buildbotics/bbctrl-pcb-new/footprints/SOD-523_0P9X1P3_ONS.step

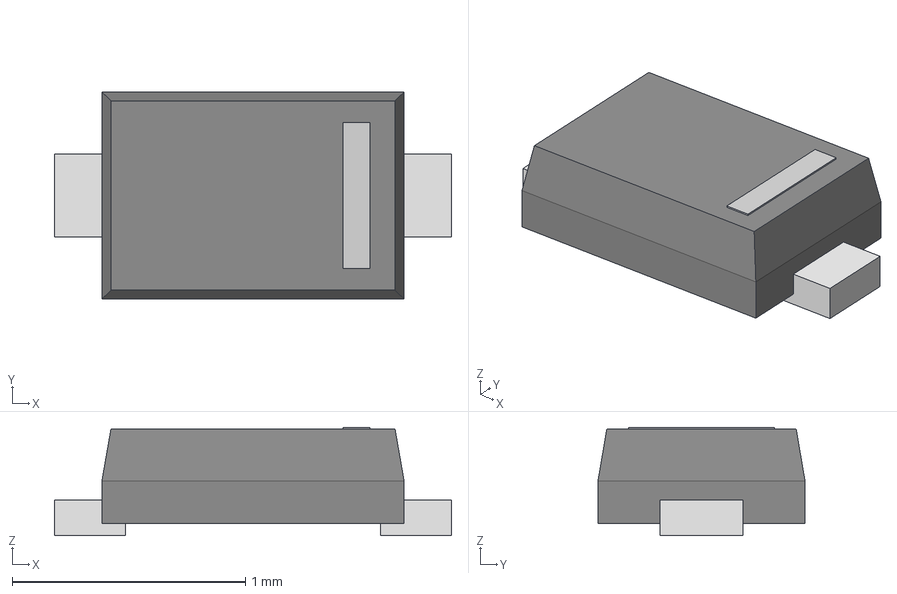
[picture p1: CAD file, 2023-02-12]
footprints/SOD-523_0P9X1P3_ONS.step
1.70 x 0.888 x 0.464 mm
