buildbotics/bbctrl-pcb-new/models/Molex_-_39-30-0060.step

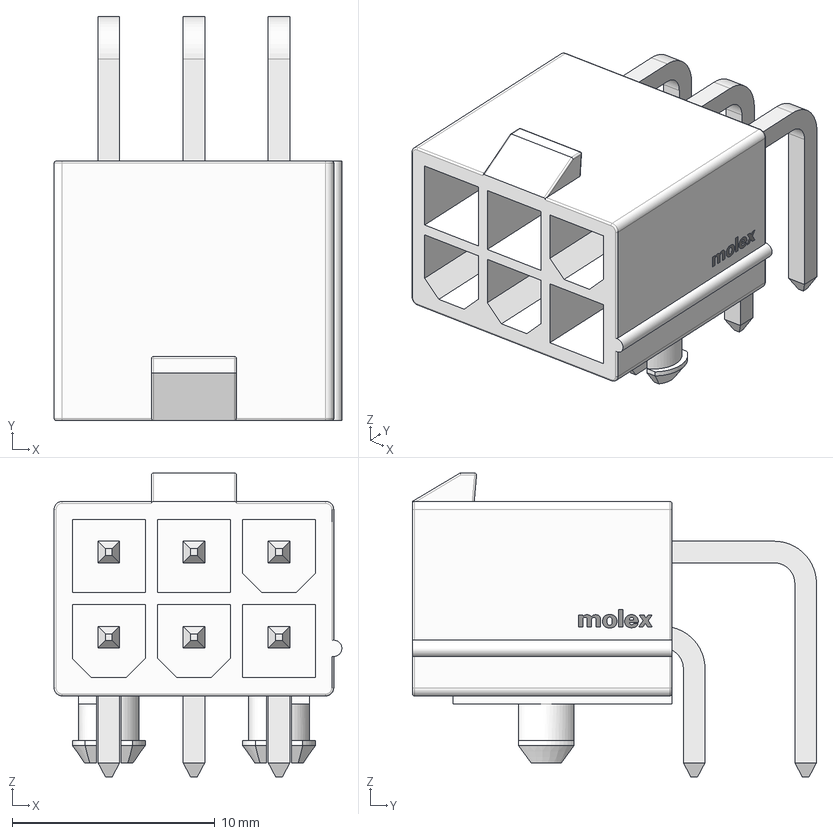
[picture p2: CAD file, 2023-07-27]
models/Molex_-_39-30-0060.step
14.2 x 19.9 x 15.0 mm
39300060_PART1 Matte Tin
Molex
