buildbotics/bbctrl-pcb-new/models/DDW0044B.stp

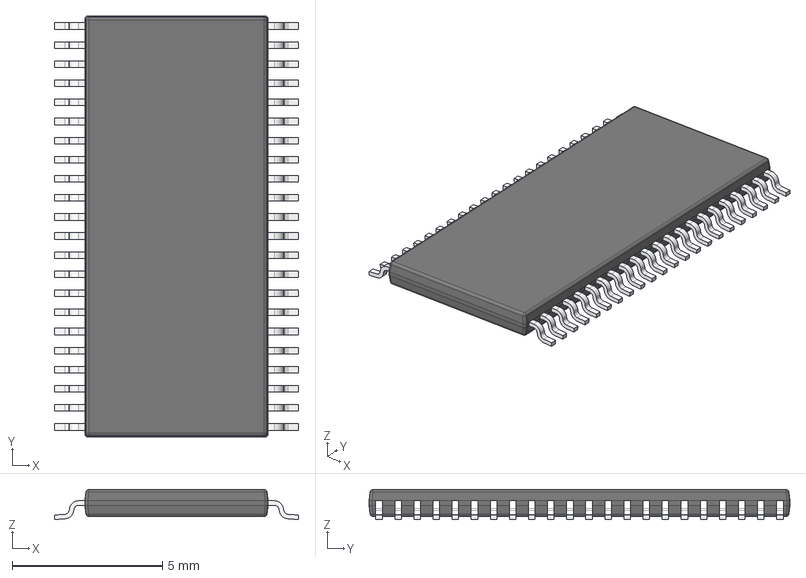
[picture p3: CAD file, 2023-04-26]
models/DDW0044B.stp
8.12 x 14.0 x 1.00 mm
BODY-SO
LEAD-SO x 44
THERMALPAD-SO
PIN1-ID
