buildbotics/bbctrl-pcb-new/models/PW0024A.stp

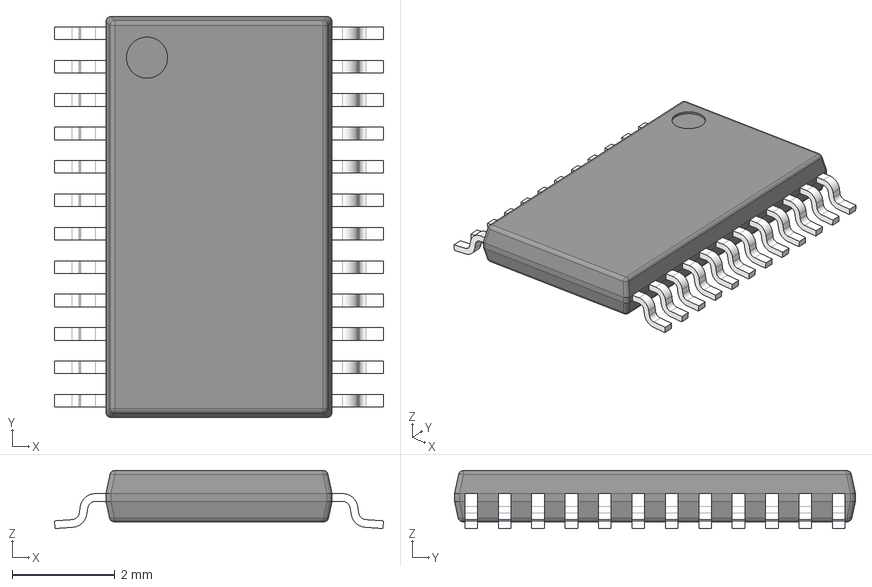
[picture p4: CAD file, 2023-04-26]
models/PW0024A.stp
6.40 x 7.80 x 1.13 mm
BODY-TSSOP
LEAD-TSSOP x 24
PIN1
