buildbotics/bbctrl-pcb-new/models/DIO_RB731_ROM.step

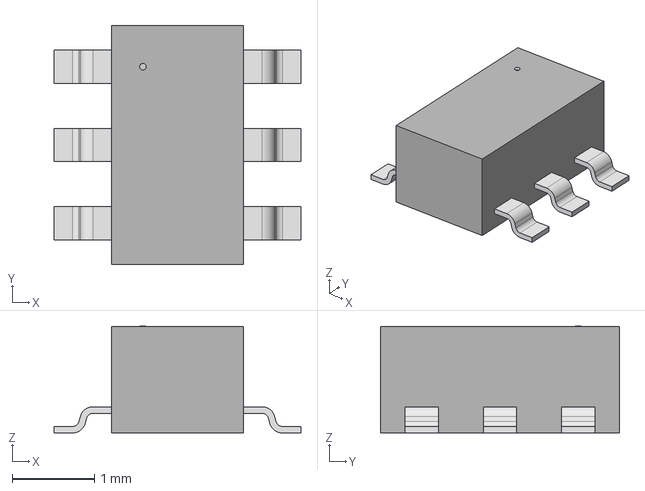
[picture p5: CAD file, 2023-04-26]
models/DIO_RB731_ROM.step
3.00 x 2.90 x 1.30 mm
