buildbotics/bbctrl-pcb-new/models/SOT23_BC856B_NEX.step

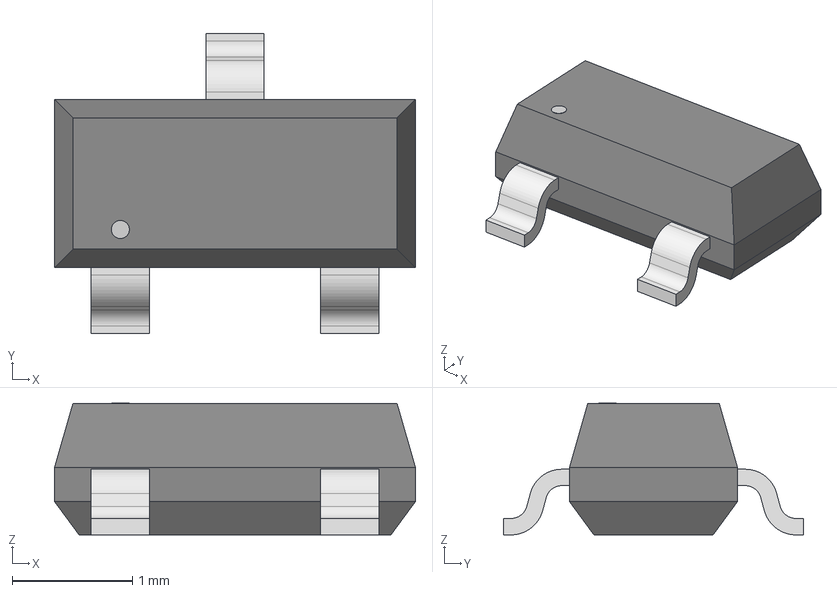
[picture p6: CAD file, 2023-02-12]
models/SOT23_BC856B_NEX.step
3.00 x 2.49 x 1.09 mm
