buildbotics/bbctrl-pcb-new/models/SOT-223_3P7X6P7_ONS.step

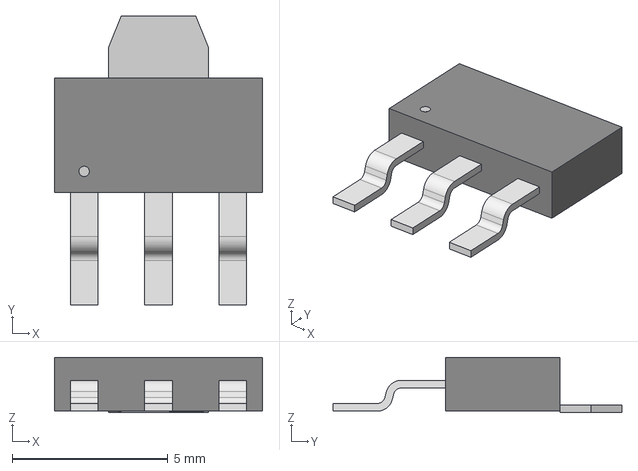
[picture p7: CAD file, 2023-02-12]
models/SOT-223_3P7X6P7_ONS.step
6.68 x 9.27 x 1.78 mm
