buildbotics/bbctrl-pcb-new/models/HTSSOP16_STM.step

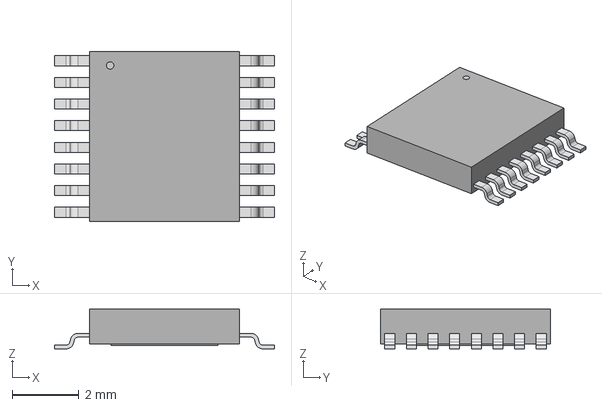
[picture p8: CAD file, 2022-10-26]
models/HTSSOP16_STM.step
6.60 x 5.11 x 1.20 mm
