buildbotics/bbctrl-pcb-new/models/IND_BOURNS_SRF2012A.step

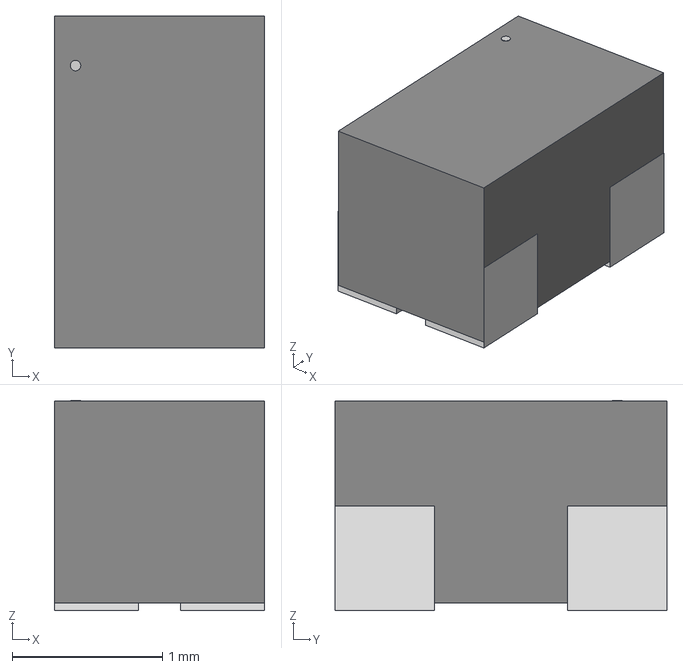
[picture p9: CAD file, 2022-10-26]
models/IND_BOURNS_SRF2012A.step
1.40 x 2.21 x 1.40 mm
