buildbotics/bbctrl-pcb-new/models/SMD_ABLS_11P4X4P7_ABR.step

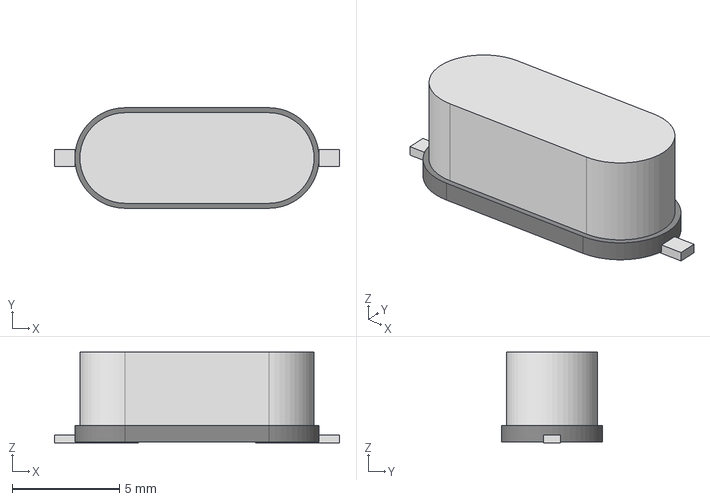
[picture p10: CAD file, 2022-10-26]
models/SMD_ABLS_11P4X4P7_ABR.step
13.3 x 4.70 x 4.24 mm
