buildbotics/bbctrl-pcb-new/models/SOIC_012IDT_STM.step

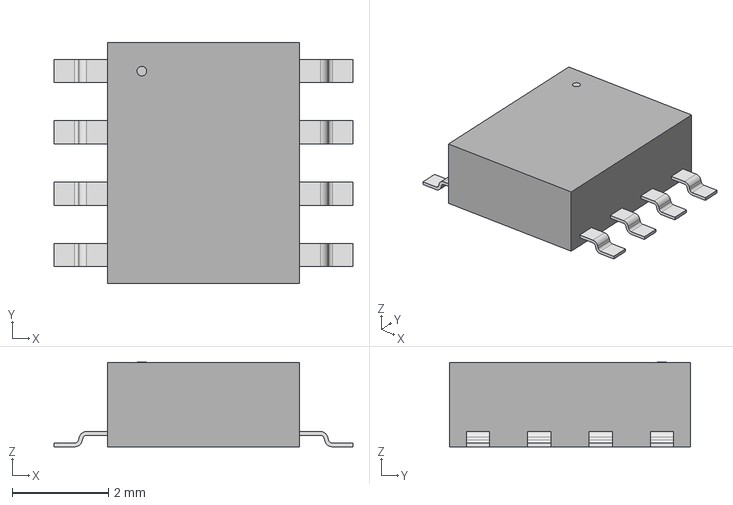
[picture p11: CAD file, 2022-10-26]
models/SOIC_012IDT_STM.step
6.20 x 5.00 x 1.75 mm
