buildbotics/bbctrl-pcb-new/models/CDBW.step

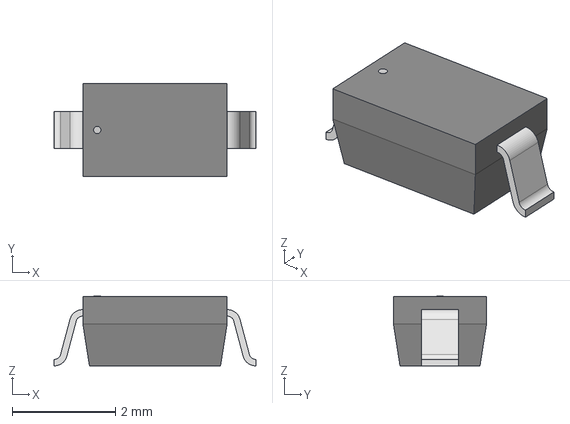
[picture p12: CAD file, 2022-10-26]
models/CDBW.step
3.91 x 1.80 x 1.35 mm
