buildbotics/bbctrl-pcb-new/models/NRS5040T3R3NMGJ.stp

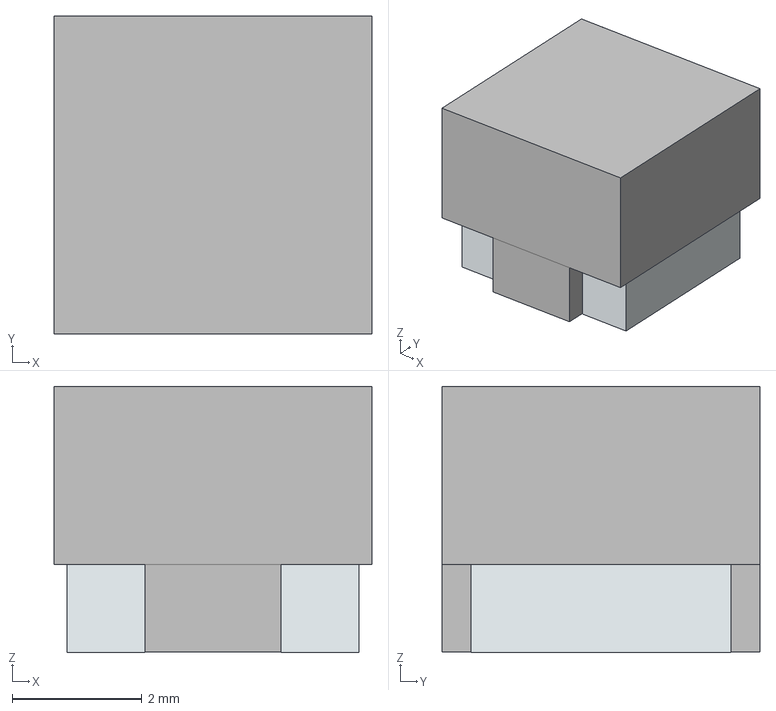
[picture p13: CAD file, 2022-10-26]
models/NRS5040T3R3NMGJ.stp
4.90 x 4.90 x 4.10 mm
solidBody
solidLead
