buildbotics/bbctrl-pcb-new/models/ON_Semiconductor_-_NVMFD5C672NLT1G.step

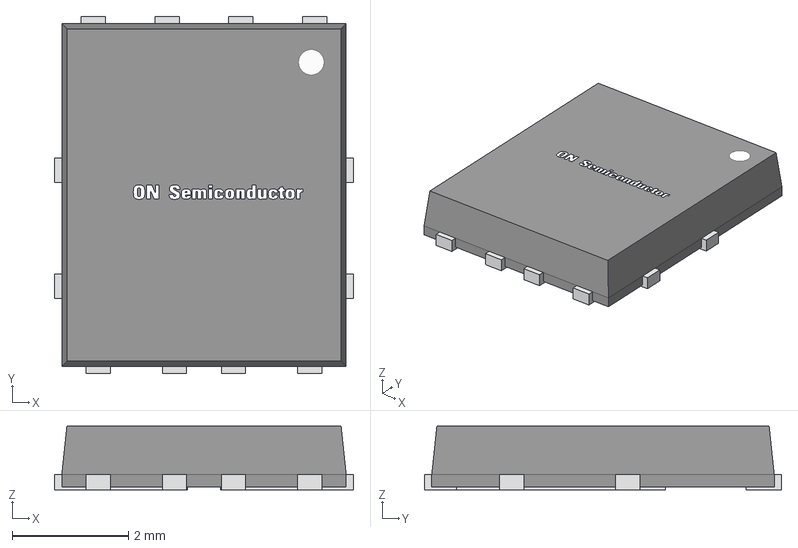
[picture p14: CAD file, 2022-10-26]
models/ON_Semiconductor_-_NVMFD5C672NLT1G.step
5.15 x 6.15 x 1.10 mm
ON Semiconductor NVMFD5C672NLT1G 1
ON Semiconductor NVMFD5C672NLT1G 2
ON Semiconductor
