buildbotics/bbctrl-pcb-new/models/TQFP-EP48_TRI.step

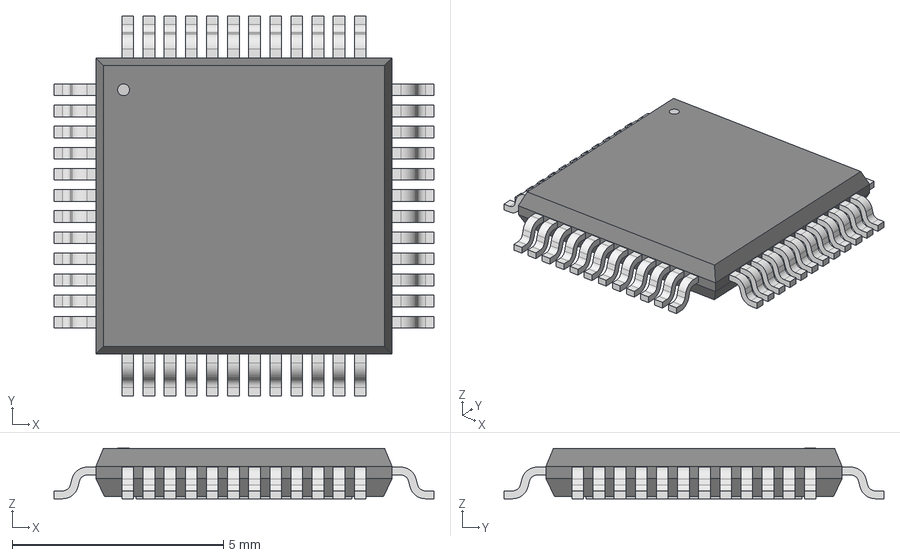
[picture p15: CAD file, 2022-10-26]
models/TQFP-EP48_TRI.step
8.99 x 8.99 x 1.20 mm
