buildbotics/bbctrl-pcb-new/models/DGQ0010D.stp

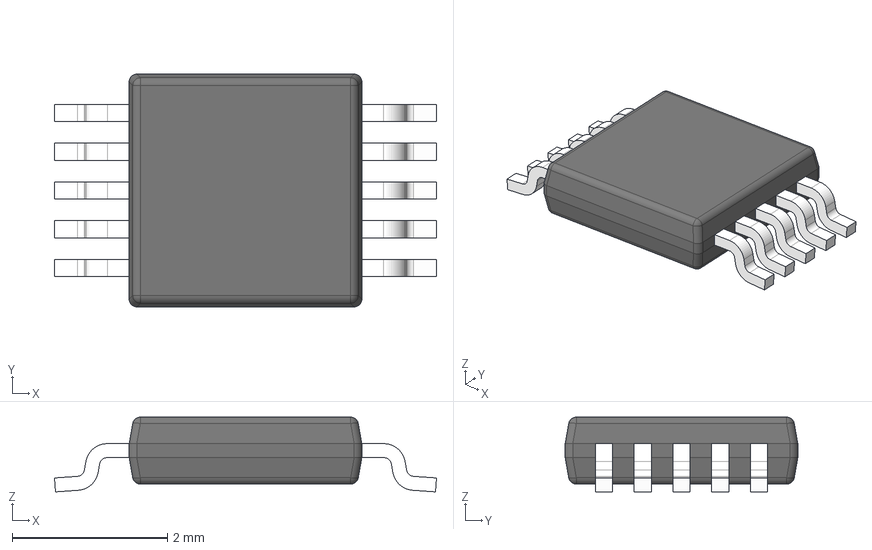
[picture p16: CAD file, 2022-10-26]
models/DGQ0010D.stp
4.93 x 3.00 x 0.964 mm
BODY-SO
LEAD-SO x 10
THERMALPAD-SO
