buildbotics/bbctrl-pcb-new/models/On_Semiconductor_-_NTD5867NLT4G.step

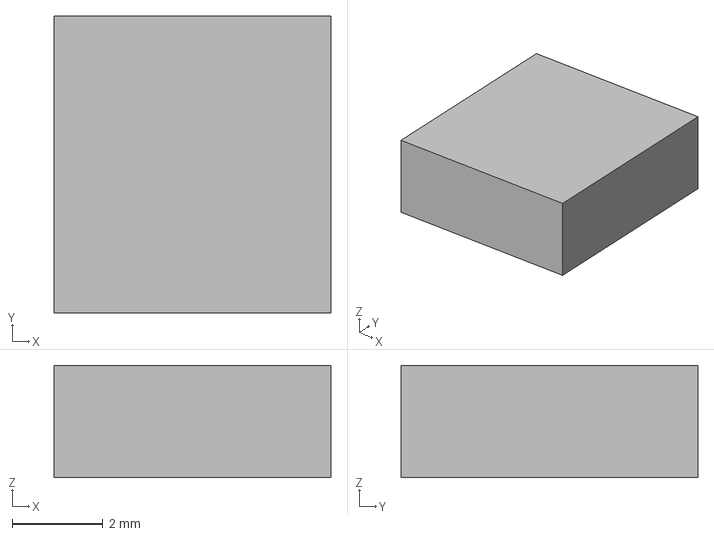
[picture p17: CAD file, 2022-10-26]
models/On_Semiconductor_-_NTD5867NLT4G.step
6.10 x 6.54 x 2.47 mm
