buildbotics/bbctrl-pcb-new/models/SOIC8_4X5_REN.step

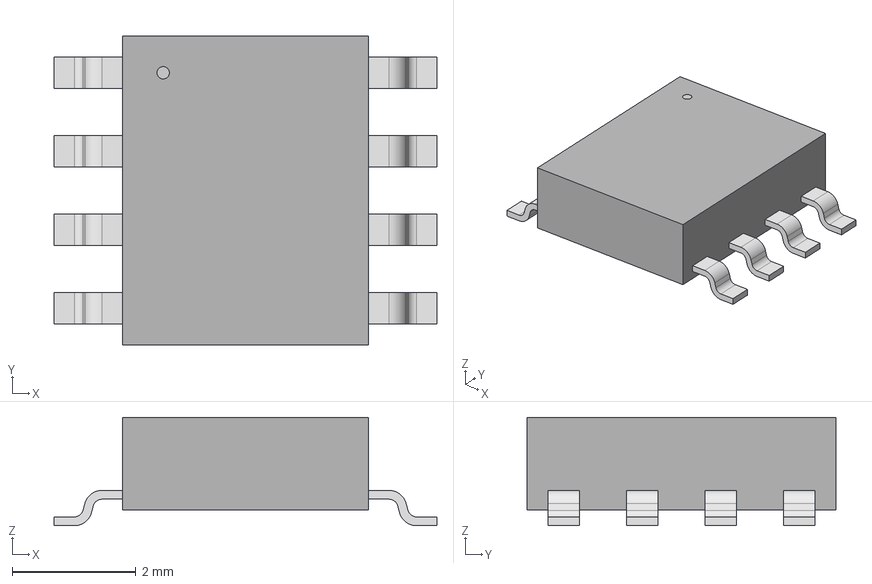
[picture p18: CAD file, 2022-10-26]
models/SOIC8_4X5_REN.step
6.20 x 5.00 x 1.75 mm
