buildbotics/bbctrl-pcb-new/models/DLW21HN121SQ2L.stp

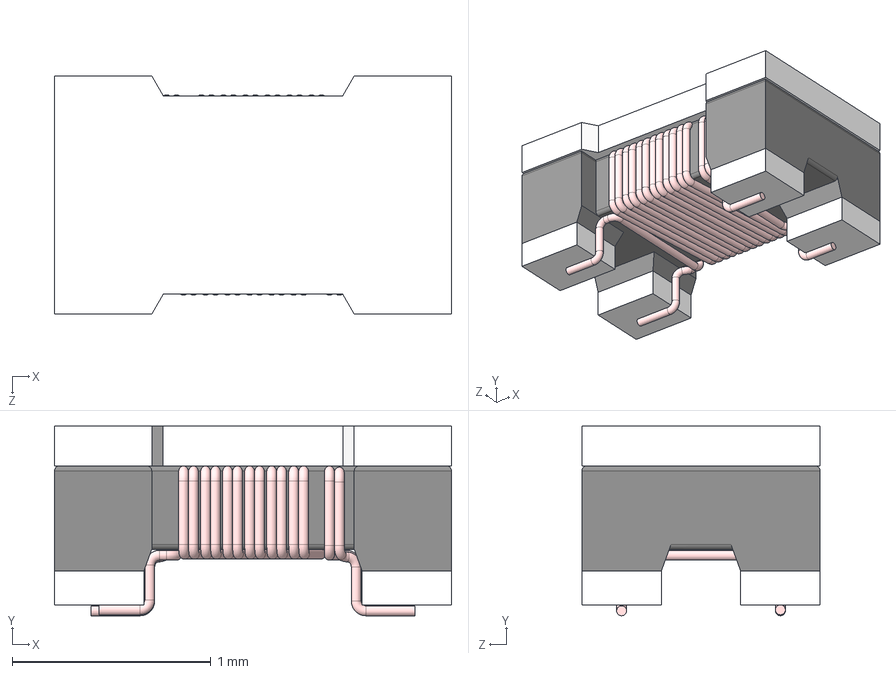
[picture p19: CAD file, 2022-10-26]
models/DLW21HN121SQ2L.stp
2.00 x 0.955 x 1.20 mm
