buildbotics/bbctrl-pcb-new/models/DCP0038A.stp

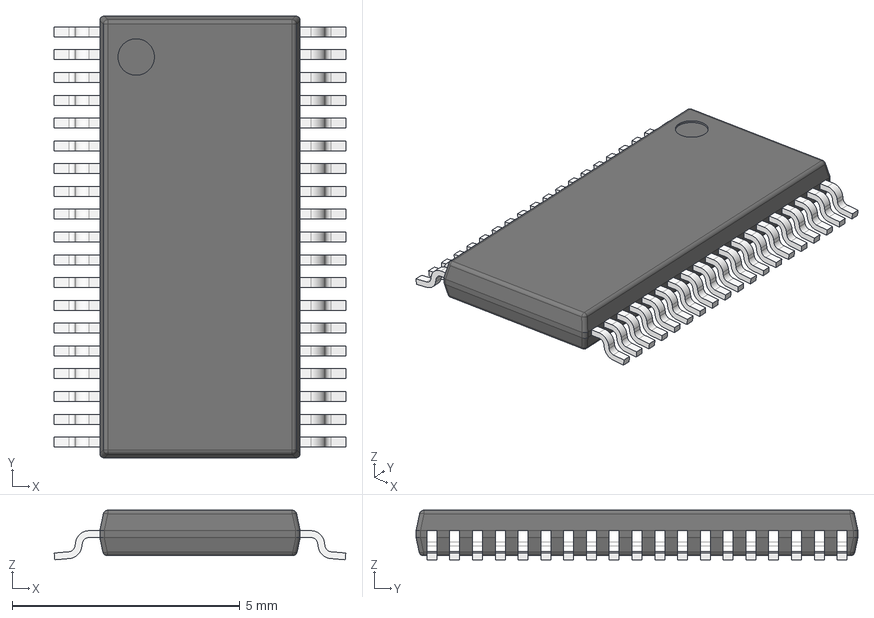
[picture p20: CAD file, 2022-10-26]
models/DCP0038A.stp
6.40 x 9.70 x 1.09 mm
BODY-TSSOP
LEAD-TSSOP x 38
PIN1
DAP
