buildbotics/bbctrl-pcb-new/models/5.0SMDJ48CA.stp

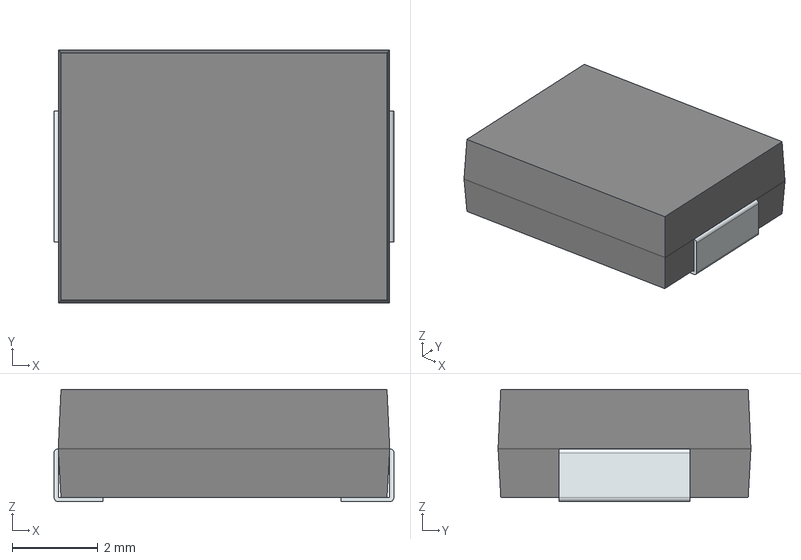
[picture p21: CAD file, 2022-10-26]
models/5.0SMDJ48CA.stp
7.94 x 5.91 x 2.62 mm
FilletPin1
FilletPin2
