buildbotics/bbctrl-pcb-new/models/DDZ6V2BQ-7.stp

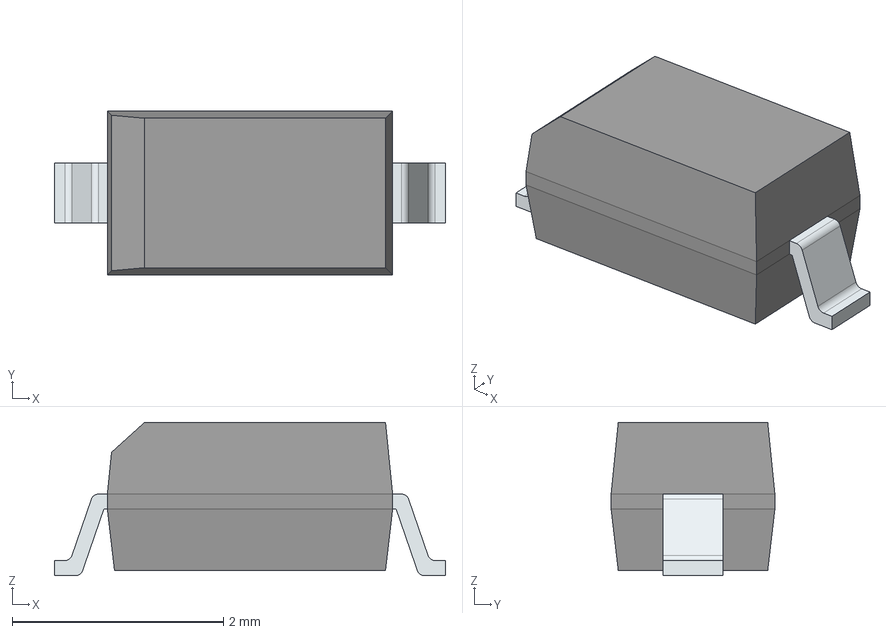
[picture p22: CAD file, 2022-10-26]
models/DDZ6V2BQ-7.stp
3.70 x 1.55 x 1.45 mm
FilletPinL
FilletPinR
