buildbotics/bbctrl-pcb-new/models/PG-TDSON-8-5_INF.step

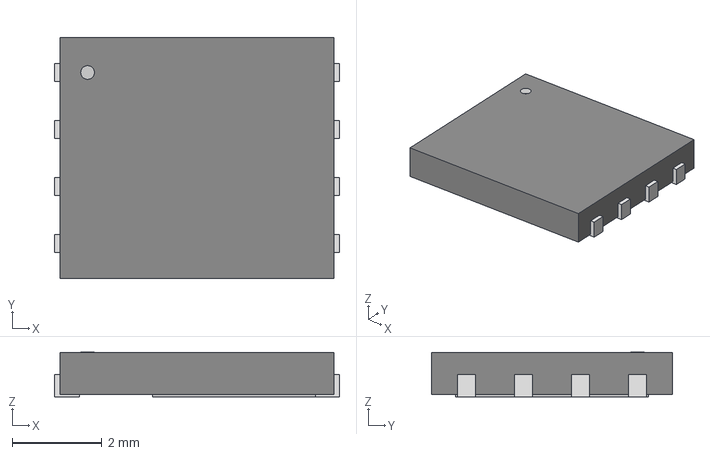
[picture p23: CAD file, 2022-10-26]
models/PG-TDSON-8-5_INF.step
6.35 x 5.36 x 0.993 mm
