buildbotics/bbctrl-pcb-new/models/ZXTR2012Z-7.stp

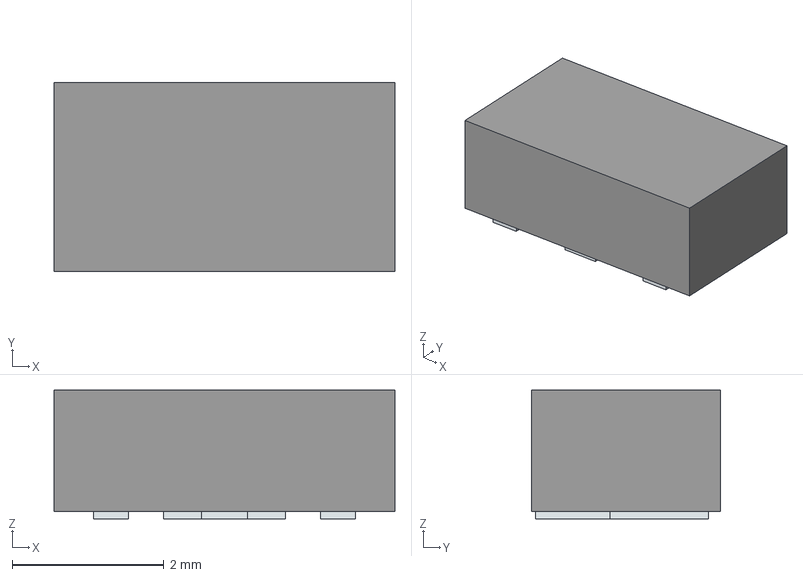
[picture p24: CAD file, 2022-10-26]
models/ZXTR2012Z-7.stp
4.50 x 2.50 x 1.70 mm
Pins
