buildbotics/bbctrl-pcb-new/models/AZ1117IH-3.3TRG1.stp

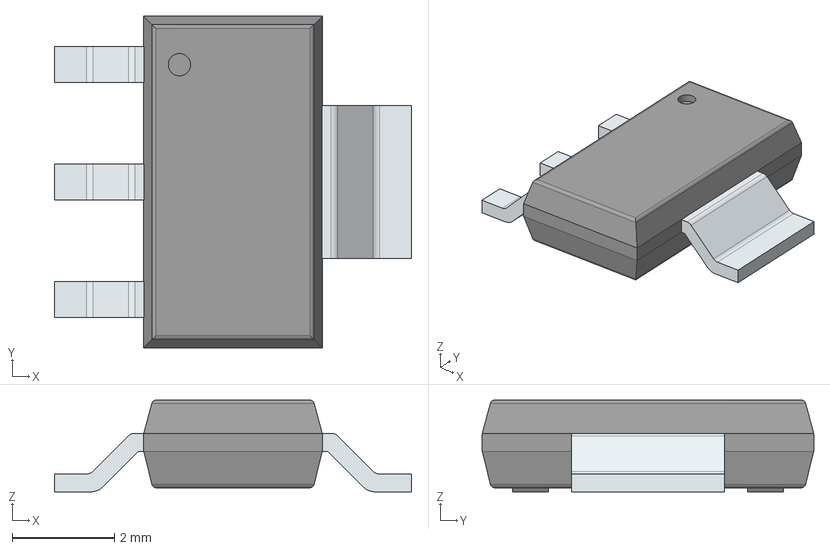
[picture p25: CAD file, 2022-10-26]
models/AZ1117IH-3.3TRG1.stp
7.00 x 6.50 x 1.80 mm
PinsArrayL
FilletPinR
