buildbotics/bbctrl-pcb-new/models/DBV0005A.stp

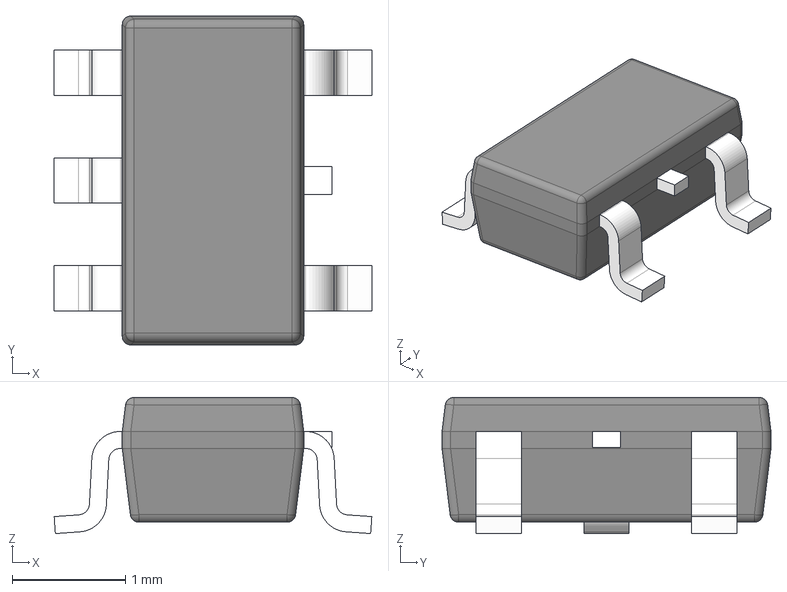
[picture p26: CAD file, 2022-10-26]
models/DBV0005A.stp
2.80 x 2.90 x 1.20 mm
BODY-SOT
LEAD-SOT x 5
LEAD-DUMMY
