buildbotics/bbctrl-pcb-new/models/Molex_-_43045-0402.step

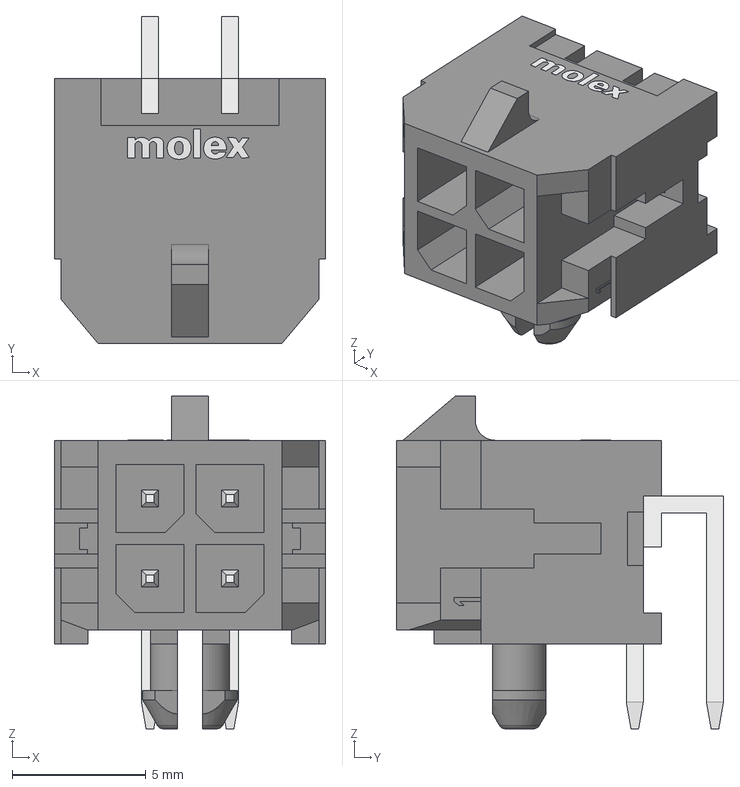
[picture p27: CAD file, 2022-10-26]
models/Molex_-_43045-0402.step
10.2 x 12.2 x 12.4 mm
