buildbotics/bbctrl-pcb-new/models/TSOT23-6_419BL_ONS.step

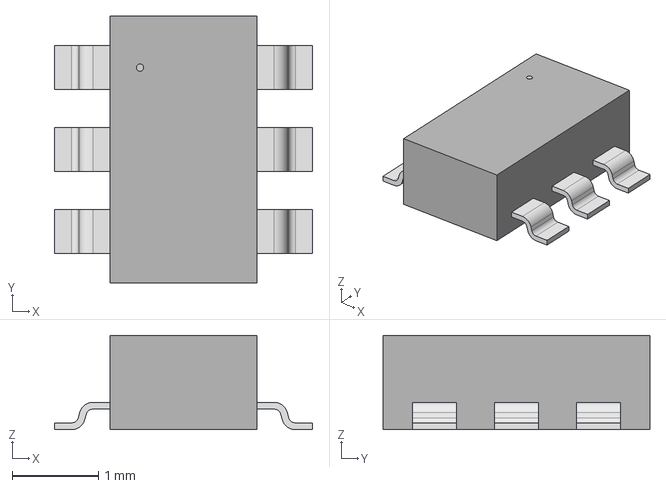
[picture p28: CAD file, 2022-10-26]
models/TSOT23-6_419BL_ONS.step
3.00 x 3.10 x 1.09 mm
