buildbotics/bbctrl-pcb-new/(list of files, cad)

Other CAD files:
models/SOD-523_0P9X1P3_ONS.step
