buildbotics/bbctrl-pcb-new/MotorDriver.kicad_sch

## KiCad design MotorDriver.kicad_sch (2023-09-02)

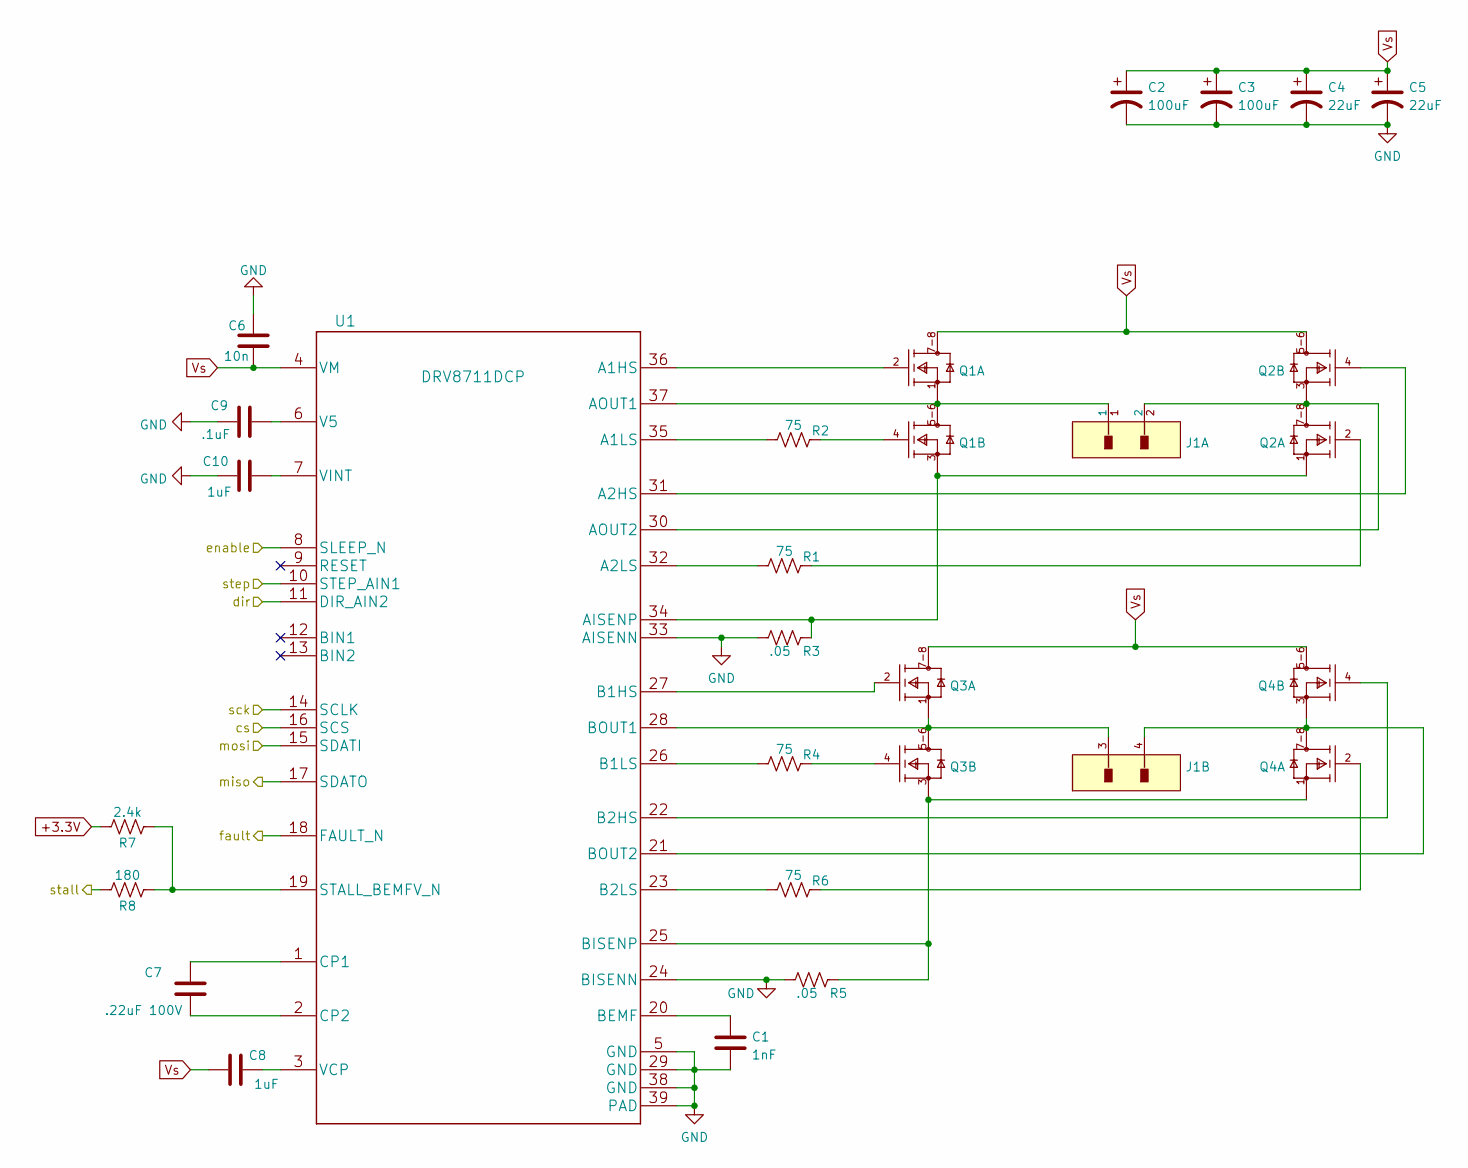
[picture p29: schematic MotorDriver.kicad_sch]

Parts:
C1: 1nF; C_0805_2012Metric_Pad1.18x1.45mm_HandSolder
C2, C3: 100uF; CP_Radial_D10.0mm_P5.00mm
C4, C5: 22uF; CP_Radial_D5.0mm_P2.00mm
C6: 10n; C_0805_2012Metric_Pad1.18x1.45mm_HandSolder
C7: .22uF 100V; C_0805_2012Metric_Pad1.18x1.45mm_HandSolder
C8, C10: 1uF; C_0805_2012Metric_Pad1.18x1.45mm_HandSolder
C9: .1uF; C_0805_2012Metric_Pad1.18x1.45mm_HandSolder
J1: 43045-0402; CON_430450402_MOL; current rating 8.5A; voltage rating 600V; mouser part number 538-43045-0402; digikey description CONN HEADER R/A 4POS 3MM
Q1, Q2, Q3, Q4: DMTH6010LPD-13; ON_Semiconductor-506BT-02_2013-E-MFG
R1, R2, R4, R6: 75; R_0805_2012Metric_Pad1.20x1.40mm_HandSolder
R3, R5: .05; R_2512_6332Metric_Pad1.40x3.35mm_HandSolder
R7: 2.4k; R_0805_2012Metric_Pad1.20x1.40mm_HandSolder
R8: 180; R_0805_2012Metric_Pad1.20x1.40mm_HandSolder
U1: DRV8711DCP

Connections:
+3.3V: R7.1
GND: C1.2, C2.2, C3.2, C4.2, C5.2, C6.1, C9.1, C10.1, R3.1, R5.1, U1.5 (GND), U1.24 (BISENN), U1.29 (GND), U1.33 (AISENN), U1.38 (GND), U1.39 (PAD)
unnamed: C1.1, U1.20 (BEMF)
unnamed: C7.1, U1.1 (CP1)
unnamed: C7.2, U1.2 (CP2)
unnamed: C8.1, U1.3 (VCP)
unnamed: C9.2, U1.6 (V5)
unnamed: C10.2, U1.7 (VINT)
unnamed: J1.1, Q1.1 (S1), Q1.5-6 (D2), U1.37 (AOUT1)
unnamed: J1.2, Q2.3 (S2), Q2.7-8 (D1), U1.30 (AOUT2)
unnamed: J1.3, Q3.1 (S1), Q3.5-6 (D2), U1.28 (BOUT1)
unnamed: J1.4, Q4.3 (S2), Q4.7-8 (D1), U1.21 (BOUT2)
unnamed: Q1.2 (G1), U1.36 (A1HS)
unnamed: Q1.3 (S2), Q2.1 (S1), R3.2, U1.34 (AISENP)
unnamed: Q1.4 (G2), R2.2
unnamed: Q2.2 (G1), R1.2
unnamed: Q2.4 (G2), U1.31 (A2HS)
unnamed: Q3.2 (G1), U1.27 (B1HS)
unnamed: Q3.3 (S2), Q4.1 (S1), R5.2, U1.25 (BISENP)
unnamed: Q3.4 (G2), R4.2
unnamed: Q4.2 (G1), R6.2
unnamed: Q4.4 (G2), U1.22 (B2HS)
unnamed: R1.1, U1.32 (A2LS)
unnamed: R2.1, U1.35 (A1LS)
unnamed: R4.1, U1.26 (B1LS)
unnamed: R6.1, U1.23 (B2LS)
unnamed: R7.2, R8.2, U1.19 (STALL_BEMFV_N)
Vs: C2.1, C3.1, C4.1, C5.1, C6.2, C8.2, Q1.7-8 (D1), Q2.5-6 (D2), Q3.7-8 (D1), Q4.5-6 (D2), U1.4 (VM)
cs: U1.16 (SCS)
dir: U1.11 (DIR_AIN2)
enable: U1.8 (SLEEP_N)
fault: U1.18 (FAULT_N)
miso: U1.17 (SDATO)
mosi: U1.15 (SDATI)
sck: U1.14 (SCLK)
stall: R8.1
step: U1.10 (STEP_AIN1)
