buildbotics/bbctrl-pcb-new/PowerSupply.kicad_sch

## KiCad design PowerSupply.kicad_sch (2024-01-30)

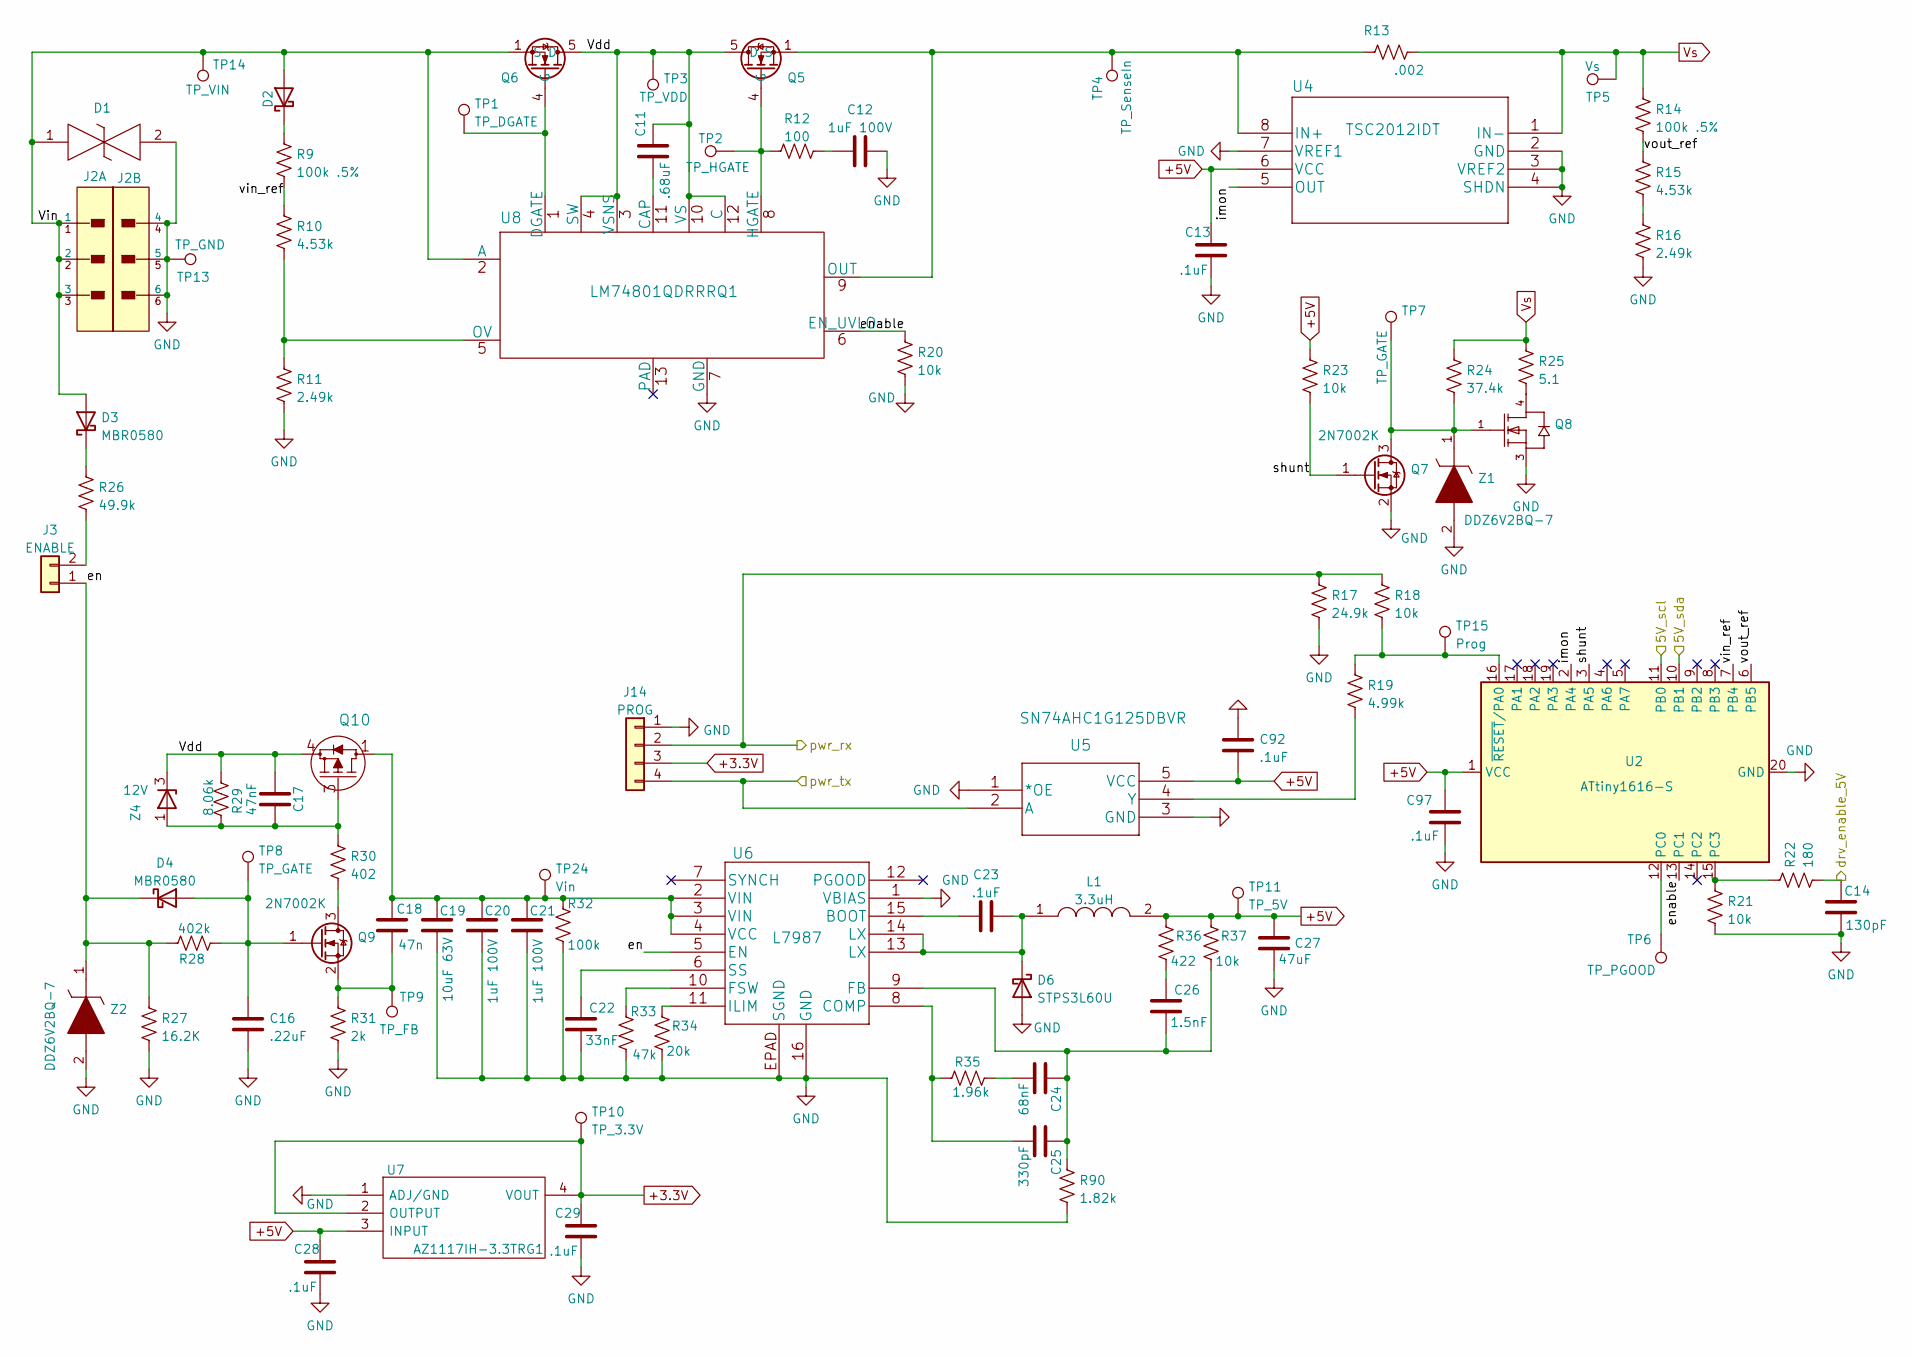
[picture p30: schematic PowerSupply.kicad_sch]

Parts:
C11: .68uF; C_1206_3216Metric_Pad1.33x1.80mm_HandSolder
C12: 1uF 100V; C_1210_3225Metric_Pad1.33x2.70mm_HandSolder
C13, C23, C28, C29, C92, C97: .1uF; C_0805_2012Metric_Pad1.18x1.45mm_HandSolder
C14: 130pF; C_0805_2012Metric_Pad1.18x1.45mm_HandSolder
C16: .22uF; C_0805_2012Metric_Pad1.18x1.45mm_HandSolder
C17: 47nF; C_0805_2012Metric_Pad1.18x1.45mm_HandSolder
C18: 47n; C_0805_2012Metric_Pad1.18x1.45mm_HandSolder
C19: 10uF 63V; C_1210_3225Metric_Pad1.33x2.70mm_HandSolder
C20, C21: 1uF 100V; C_0805_2012Metric_Pad1.18x1.45mm_HandSolder
C22: 33nF; C_0805_2012Metric_Pad1.18x1.45mm_HandSolder
C24: 68nF; C_0805_2012Metric_Pad1.18x1.45mm_HandSolder
C25: 330pF; C_0805_2012Metric_Pad1.18x1.45mm_HandSolder
C26: 1.5nF; C_0805_2012Metric_Pad1.18x1.45mm_HandSolder
C27: 47uF; C_1210_3225Metric_Pad1.33x2.70mm_HandSolder
D1: 5.0SMDJ48CA; DIONM7959X262N; Manufacturer_Part_Number 5.0SMDJ48CA; Mouser Part Number 652-5.0SMDJ48CA
D2, D3, D4: MBR0580; D_SOD-123
D6: STPS3L60U; D_2010_5025Metric
J2: 39-30-0060; Molex-39-30-0060-MFG; current rating 13A; voltage rating 600V; mouser part number 538-39-30-0060; digikey description CONN HEADER R/A 6POS 4.2MM
J3: ENABLE; PinHeader_1x02_P2.54mm_Vertical
J14: PROG; PinHeader_1x04_P2.54mm_Vertical
L1: 3.3uH; NRS5040T3R3NMGJ; Manufacturer_Part_Number NRS5040T3R3NMGJ; Mouser Part Number 963-NRS5040T3R3NMGJ
Q5, Q6: BSC040N08NS5ATMA1; INFINEON_PG-TDSON-8-5; Manufacturer_Part_Number BSC040N08NS5ATMA1; Mouser Part Number 726-BSC040N08NS5ATMA
Q7, Q9: 2N7002K; SOT-23
Q8: NTD5867NLT4G; On_Semiconductor-NTD5867NLT4G-Manufacturer_Recommended
Q10: FDC5614P
R9, R14: 100k .5%; R_0805_2012Metric_Pad1.20x1.40mm_HandSolder
R10, R15: 4.53k; R_0805_2012Metric_Pad1.20x1.40mm_HandSolder
R11, R16: 2.49k; R_0805_2012Metric_Pad1.20x1.40mm_HandSolder
R12: 100; R_0805_2012Metric_Pad1.20x1.40mm_HandSolder
R13: .002; 2512_Sense
R17: 24.9k; R_0805_2012Metric_Pad1.20x1.40mm_HandSolder
R18, R20, R21, R23, R37: 10k; R_0805_2012Metric_Pad1.20x1.40mm_HandSolder
R19: 4.99k; R_0805_2012Metric_Pad1.20x1.40mm_HandSolder
R22: 180; R_0805_2012Metric_Pad1.20x1.40mm_HandSolder
R24: 37.4k; R_0805_2012Metric_Pad1.20x1.40mm_HandSolder
R25: 5.1; R_Axial_Power_L25.0mm_W9.0mm_P30.48mm
R26: 49.9k; R_0805_2012Metric_Pad1.20x1.40mm_HandSolder
R27: 16.2K; R_0805_2012Metric_Pad1.20x1.40mm_HandSolder
R28: 402k; R_0805_2012Metric_Pad1.20x1.40mm_HandSolder
R29: 8.06k; R_0805_2012Metric_Pad1.20x1.40mm_HandSolder
R30: 402; R_0805_2012Metric_Pad1.20x1.40mm_HandSolder
R31: 2k; R_0805_2012Metric_Pad1.20x1.40mm_HandSolder
R32: 100k; R_0805_2012Metric_Pad1.20x1.40mm_HandSolder
R33: 47k; R_0805_2012Metric_Pad1.20x1.40mm_HandSolder
R34: 20k; R_0805_2012Metric_Pad1.20x1.40mm_HandSolder
R35: 1.96k; R_0805_2012Metric_Pad1.20x1.40mm_HandSolder
R36: 422; R_0805_2012Metric_Pad1.20x1.40mm_HandSolder
R90: 1.82k; R_0805_2012Metric_Pad1.20x1.40mm_HandSolder
TP1: TP_DGATE; test_point
TP2: TP_HGATE; PinHeader_1x01_P1.00mm_Vertical
TP3: TP_VDD; test_point
TP4: TP_SenseIn; test_point
TP5: Vs; test_point
TP6: TP_PGOOD; test_point
TP7: TP_GATE; PinHeader_1x01_P1.00mm_Vertical
TP8: TP_GATE; test_point
TP9: TP_FB; PinHeader_1x01_P1.00mm_Vertical
TP10: TP_3.3V; test_point
TP11: TP_5V; test_point
TP13: TP_GND; test_point
TP14: TP_VIN; test_point
TP15: Prog; test_point
TP24: Vin; test_point
U2: ATtiny1616-S; SOIC-20W_7.5x12.8mm_P1.27mm
U4: TSC2012IDT
U5: SN74AHC1G125DBVR
U6: L7987
U7: AZ1117IH-3.3TRG1; SOT230P700X180-4N; Manufacturer_Part_Number AZ1117IH-3.3TRG1; Mouser Part Number 621-AZ1117IH-3.3TRG1
U8: LM74801QDRRRQ1; LM74800QDRRRQ1
Z1, Z2: DDZ6V2BQ-7; SOD3716X145N; Manufacturer_Part_Number DDZ6V2BQ-7; Mouser Part Number 621-DDZ6V2BQ-7
Z4: 12V; SOT-23

Connections:
5V_scl: U2.11 (PB0)
5V_sda: U2.10 (PB1)
+3.3V: C29.1, J14.3, TP10.1, U7.2 (OUTPUT), U7.4 (VOUT)
+5V: C13.1, C27.1, C28.1, C92.2, C97.1, L1.2, R23.1, R36.1, R37.1, TP11.1, U2.1 (VCC), U4.6 (VCC), U5.5 (VCC), U7.3 (INPUT)
GND: C12.2, C13.2, C14.1, C16.2, C19.2, C20.2, C21.2, C22.2, C27.2, C28.2, C29.2, C97.2, D1.2, D6.2 (A), J2.4, J2.5, J2.6, J14.1, Q7.2 (S), Q8.3 (S), R11.2, R16.2, R17.2, R20.2, R21.2, R27.2, R31.2, R32.2, R33.2, R34.2, R90.2, TP13.1, U2.20 (GND), U4.2 (GND), U4.3 (VREF2), U4.4 (SHDN), U4.7 (VREF1), U5.1 (*OE), U6.1 (VBIAS), U6.16 (GND), U6.EPAD (SGND), U7.1 (ADJ/GND), U8.7 (GND), Z1.2, Z2.2
unnamed: C11.2, U8.11 (CAP)
unnamed: C12.1, R12.2
unnamed: C16.1, D4.2 (A), Q9.1 (G), R28.2, TP8.1
unnamed: C17.1, Q10.3, R29.1, R30.1, Z4.1
unnamed: C18.1, C19.1, C20.1, C21.1, Q10.1, Q10.2, Q10.5, Q10.6, R32.1, TP24.1, U6.2 (VIN), U6.3 (VIN), U6.4 (VCC)
unnamed: C18.2, Q9.2 (S), R31.1, TP9.1
unnamed: C22.1, U6.6 (SS)
unnamed: C23.1, U6.15 (BOOT)
unnamed: C23.2, D6.1 (K), L1.1, U6.13 (LX), U6.14 (LX)
unnamed: C24.1, C25.1, C26.2, R37.2, R90.1, U6.9 (FB)
unnamed: C24.2, R35.2
unnamed: C25.2, R35.1, U6.8 (COMP)
unnamed: C26.1, R36.2
unnamed: D2.1 (K), R9.1
unnamed: D3.1 (K), R26.1
unnamed: J3.2, R26.2
unnamed: Q5.1 (S), Q5.2 (S), Q5.3 (S), R13.1, TP4.1, U4.8 (IN+), U8.9 (OUT)
unnamed: Q5.4 (G), R12.1, TP2.1, U8.8 (HGATE)
unnamed: Q6.4 (G), TP1.1, U8.1 (DGATE)
unnamed: Q7.3 (D), Q8.1 (G), R24.2, TP7.1, Z1.1
unnamed: Q8.4 (D), R25.2
unnamed: Q9.3 (D), R30.2
unnamed: R10.2, R11.1, U8.5 (OV)
unnamed: R15.2, R16.1
unnamed: R18.2, R19.1, TP15.1, U2.16 (~RESET/PA0)
unnamed: R19.2, U5.4 (Y)
unnamed: R21.1, R22.1, U2.15 (PC3)
unnamed: R33.1, U6.10 (FSW)
unnamed: R34.1, U6.11 (ILIM)
unnamed: TP6.1, U2.12 (PC0)
Vdd: C11.1, C17.2, Q5.5 (D), Q5.6 (D), Q5.7 (D), Q5.8 (D), Q6.5 (D), Q6.6 (D), Q6.7 (D), Q6.8 (D), Q10.4, R29.2, TP3.1, U8.3 (VSNS), U8.4 (SW), U8.10 (VS), U8.12 (C), Z4.3
Vin: D1.1, D2.2 (A), D3.2 (A), J2.1, J2.2, J2.3, Q6.1 (S), Q6.2 (S), Q6.3 (S), TP14.1, U8.2 (A)
Vs: R13.2, R14.1, R24.1, R25.1, TP5.1, U4.1 (IN-)
drv_enable_5V: C14.2, R22.2
en: D4.1 (K), J3.1, R27.1, R28.1, U6.5 (EN), Z2.1
enable: R20.1, U2.13 (PC1), U8.6 (EN_UVLO)
imon: U2.2 (PA4), U4.5 (OUT)
pwr_rx: J14.2, R17.1, R18.1
pwr_tx: J14.4, U5.2 (A)
shunt: Q7.1 (G), R23.2, U2.3 (PA5)
vin_ref: R9.2, R10.1, U2.7 (PB4)
vout_ref: R14.2, R15.1, U2.6 (PB5)
~: C92.1, U5.3 (GND)
