buildbotics/bbctrl-pcb-new/level_shifter.kicad_sch

## KiCad design level_shifter.kicad_sch (2024-01-30)

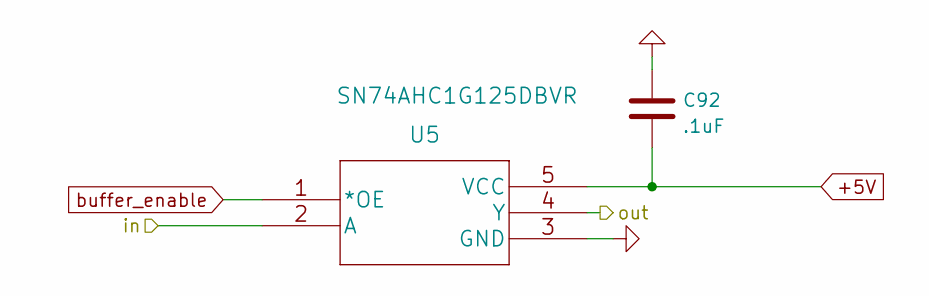
[picture p31: schematic level_shifter.kicad_sch]

Parts:
C92: .1uF; C_0805_2012Metric_Pad1.18x1.45mm_HandSolder
U5: SN74AHC1G125DBVR

Connections:
+5V: C92.2, U5.5 (VCC)
buffer_enable: U5.1 (*OE)
in: U5.2 (A)
out: U5.4 (Y)
~: C92.1, U5.3 (GND)
