buildbotics/bbctrl-pcb-new/microprocessor.kicad_sch

## KiCad design microprocessor.kicad_sch (2023-09-09)

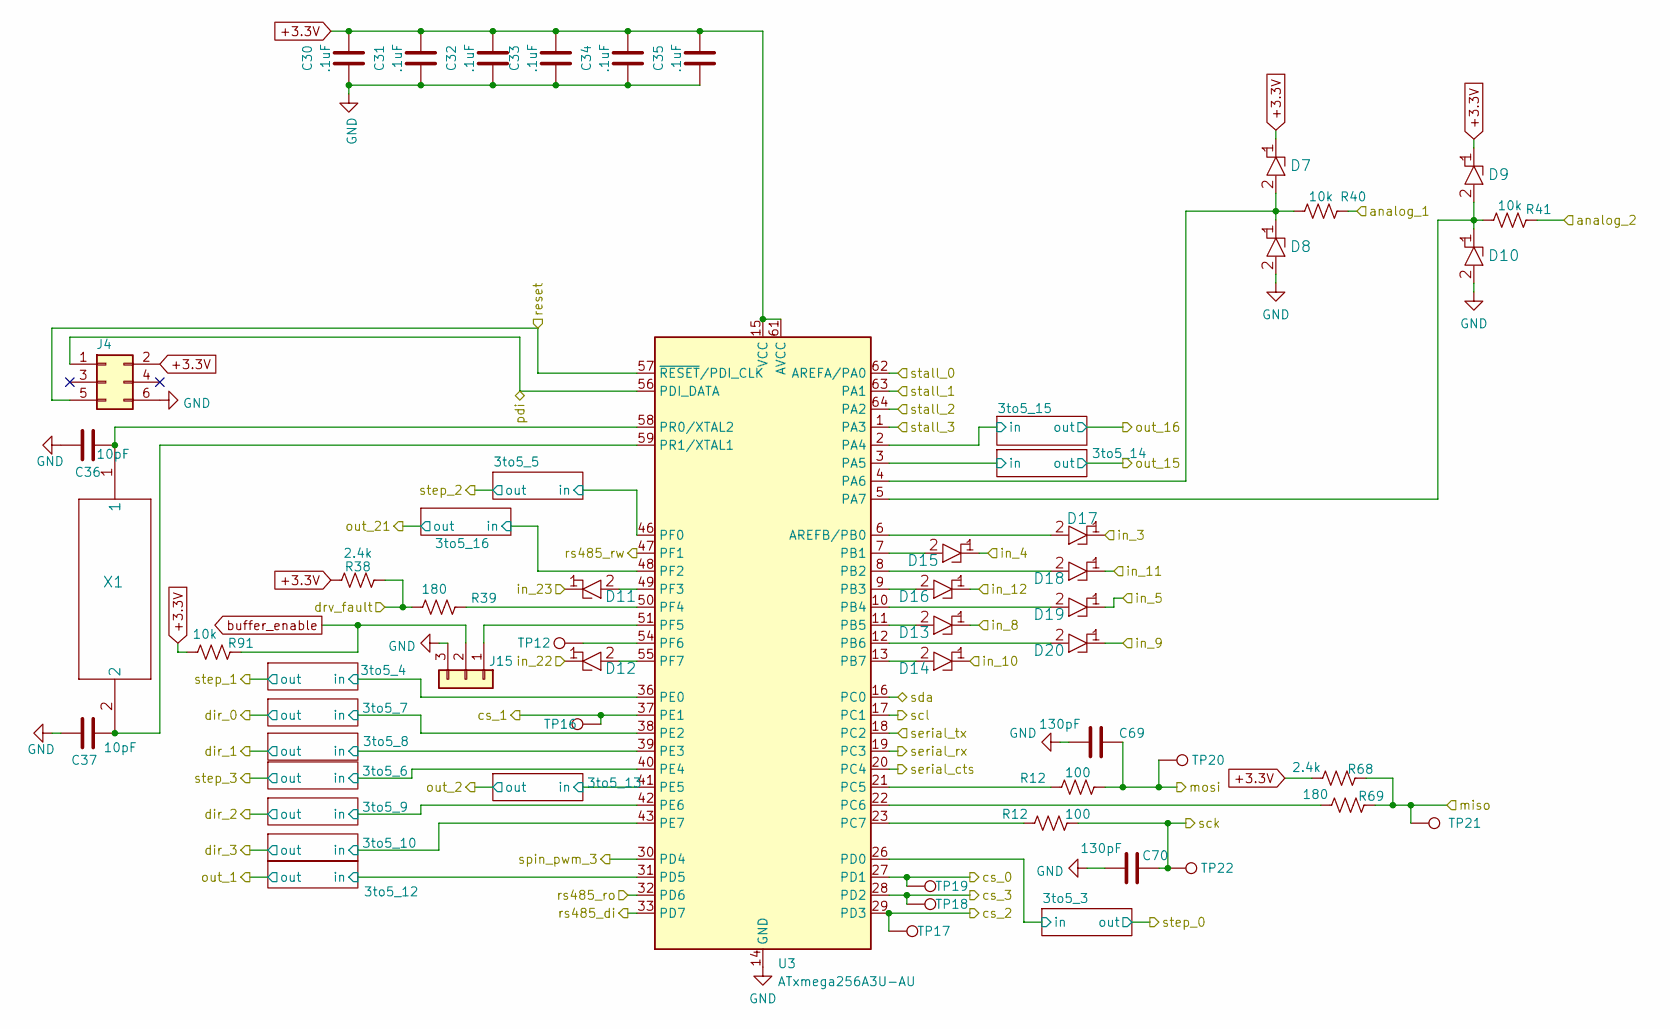
[picture p32: schematic microprocessor.kicad_sch]

Parts:
C30, C31, C32, C33, C34, C35: .1uF; C_0805_2012Metric_Pad1.18x1.45mm_HandSolder
C36, C37: 10pF; C_0805_2012Metric_Pad1.18x1.45mm_HandSolder
C69, C70: 130pF; C_0805_2012Metric_Pad1.18x1.45mm_HandSolder
D7, D8, D9, D10: RB521S30T1G
D11, D12, D13, D14, D15, D16, D17, D18, D19, D20: CDBW46-G
J4: Conn_02x03_Odd_Even; PinHeader_2x03_P2.54mm_Vertical
J15: Conn_01x03; PinHeader_1x03_P2.54mm_Vertical
R12: 100; R_0805_2012Metric_Pad1.20x1.40mm_HandSolder
R38, R68: 2.4k; R_0805_2012Metric_Pad1.20x1.40mm_HandSolder
R39, R69: 180; R_0805_2012Metric_Pad1.20x1.40mm_HandSolder
R40, R41, R91: 10k; R_0805_2012Metric_Pad1.20x1.40mm_HandSolder
TP12, TP16, TP17, TP18, TP19, TP20, TP21, TP22: test; test_point
U3: ATxmega256A3U-AU; TQFP-64_14x14mm_P0.8mm
X1: ABLS-16.000MHZ-B4-T

Connections:
+3.3V: C30.2, C31.2, C32.2, C33.2, C34.2, C35.2, D7.1, D9.1, J4.2, R38.1, R68.1, R91.1, U3.15 (VCC), U3.25 (VCC), U3.35 (VCC), U3.45 (VCC), U3.53 (VCC), U3.61 (AVCC)
GND: C30.1, C31.1, C32.1, C33.1, C34.1, C35.1, C36.1, C37.1, C69.1, C70.1, D8.2, D10.2, J4.6, J15.3, U3.14 (GND), U3.24 (GND), U3.34 (GND), U3.44 (GND), U3.52 (GND), U3.60 (GND)
unnamed: C36.2, U3.58 (PR0/XTAL2), X1.1
unnamed: C37.2, U3.59 (PR1/XTAL1), X1.2
unnamed: D7.2, D8.1, R40.1, U3.4 (PA6)
unnamed: D9.2, D10.1, R41.1, U3.5 (PA7)
unnamed: D11.2, U3.49 (PF3)
unnamed: D12.2, U3.55 (PF7)
unnamed: D13.2, U3.11 (PB5)
unnamed: D14.2, U3.13 (PB7)
unnamed: D15.2, U3.7 (PB1)
unnamed: D16.2, U3.9 (PB3)
unnamed: D17.2, U3.6 (AREFB/PB0)
unnamed: D18.2, U3.8 (PB2)
unnamed: D19.2, U3.10 (PB4)
unnamed: D20.2, U3.12 (PB6)
unnamed: J15.1, U3.51 (PF5)
unnamed: R12.1, U3.21 (PC5), U3.23 (PC7)
unnamed: R39.2, U3.50 (PF4)
unnamed: R69.1, U3.22 (PC6)
unnamed: TP12.1, U3.54 (PF6)
analog_1: R40.2
analog_2: R41.2
buffer_enable: J15.2, R91.2
cs_0: TP19.1, U3.27 (PD1)
cs_1: TP16.1, U3.37 (PE1)
cs_2: TP17.1, U3.29 (PD3)
cs_3: TP18.1, U3.28 (PD2)
drv_fault: R38.2, R39.1
in: U3.2 (PA4), U3.3 (PA5), U3.26 (PD0), U3.31 (PD5), U3.36 (PE0), U3.38 (PE2), U3.39 (PE3), U3.40 (PE4), U3.41 (PE5), U3.42 (PE6), U3.43 (PE7), U3.46 (PF0), U3.48 (PF2)
in_3: D17.1
in_4: D15.1
in_5: D19.1
in_8: D13.1
in_9: D20.1
in_10: D14.1
in_11: D18.1
in_12: D16.1
in_22: D12.1
in_23: D11.1
miso: R68.2, R69.2, TP21.1
mosi: C69.2, R12.2, TP20.1
pdi: J4.1, U3.56 (PDI_DATA)
reset: J4.5, U3.57 (~RESET/PDI_CLK)
rs485_di: U3.33 (PD7)
rs485_ro: U3.32 (PD6)
rs485_rw: U3.47 (PF1)
sck: C70.2, R12.2, TP22.1
scl: U3.17 (PC1)
sda: U3.16 (PC0)
serial_cts: U3.20 (PC4)
serial_rx: U3.19 (PC3)
serial_tx: U3.18 (PC2)
spin_pwm_3: U3.30 (PD4)
stall_0: U3.62 (AREFA/PA0)
stall_1: U3.63 (PA1)
stall_2: U3.64 (PA2)
stall_3: U3.1 (PA3)
