buildbotics/bbctrl-pcb-new/peripherals.kicad_sch

## KiCad design peripherals.kicad_sch (2023-09-07)

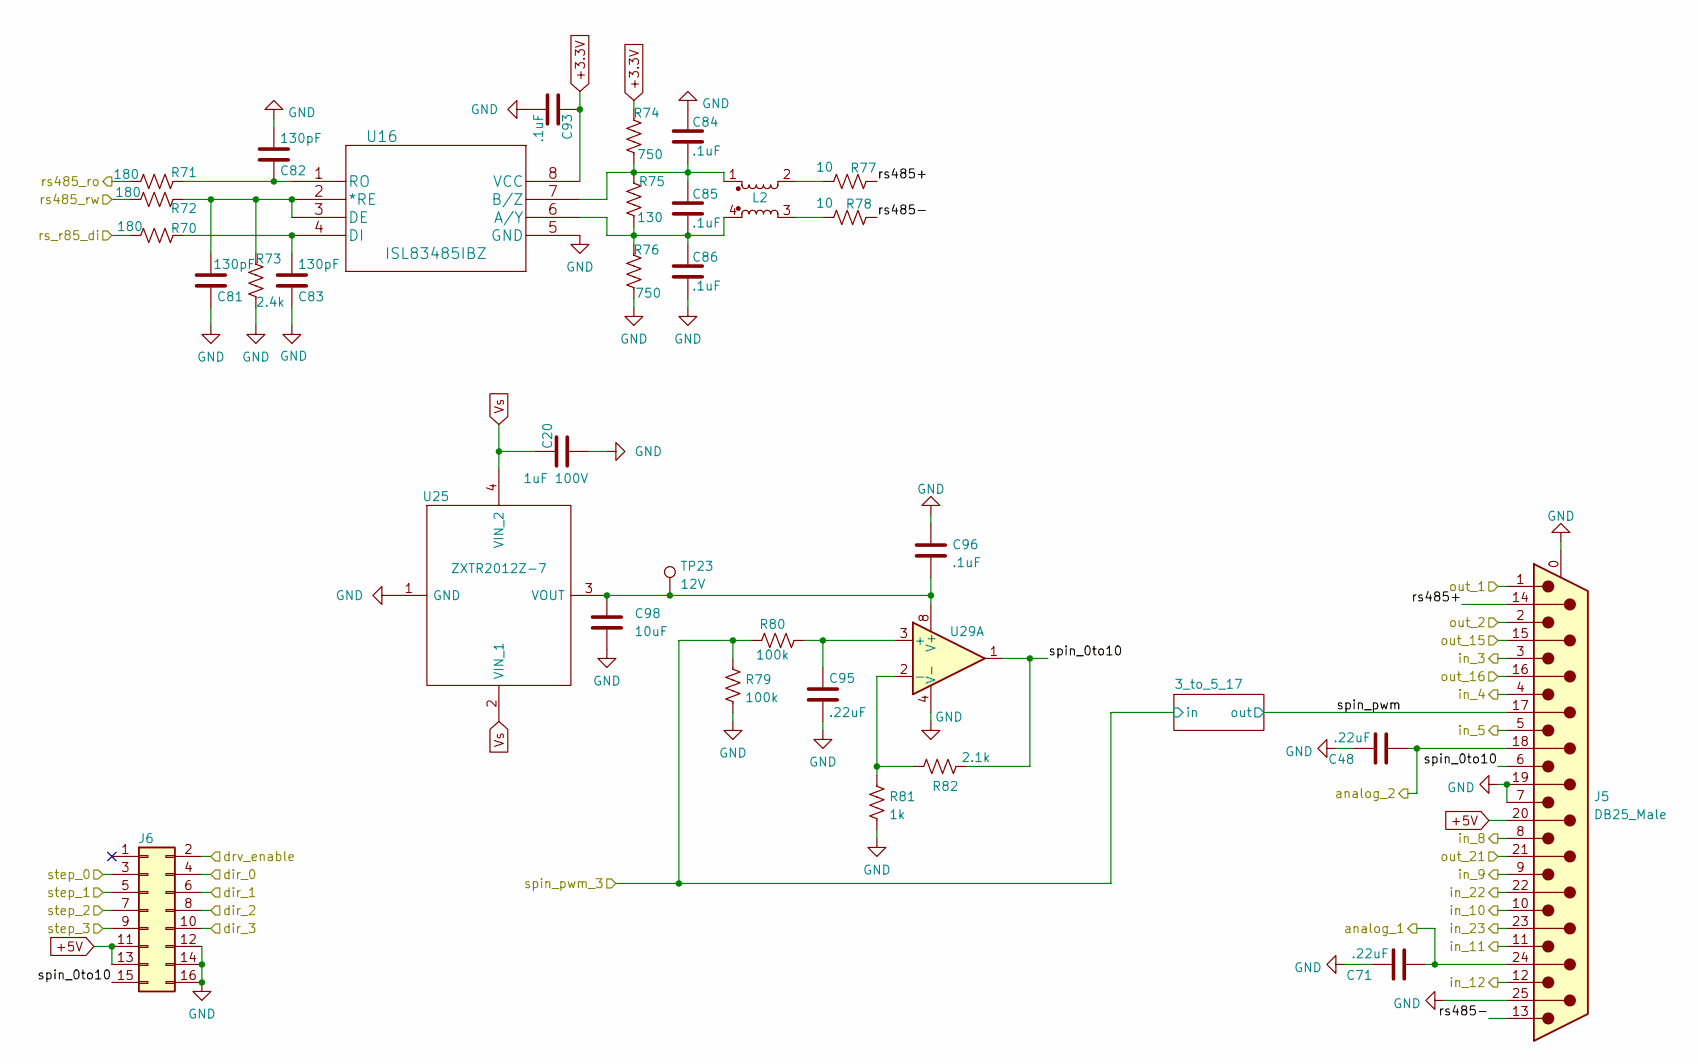
[picture p33: schematic peripherals.kicad_sch]

Parts:
C20: 1uF 100V; C_0805_2012Metric_Pad1.18x1.45mm_HandSolder
C48, C71, C95: .22uF; C_0805_2012Metric_Pad1.18x1.45mm_HandSolder
C81, C82, C83: 130pF; C_0805_2012Metric_Pad1.18x1.45mm_HandSolder
C84, C85, C86, C93, C96: .1uF; C_0805_2012Metric_Pad1.18x1.45mm_HandSolder
C98: 10uF; C_1206_3216Metric_Pad1.33x1.80mm_HandSolder
J5: DB25_Male; 182025113R161
J6: Conn_02x08_Odd_Even; PinHeader_2x08_P2.54mm_Vertical
L2: L_Coupled_1243; SRF2012-121YA
R70, R71, R72: 180; R_0805_2012Metric_Pad1.20x1.40mm_HandSolder
R73: 2.4k; R_0805_2012Metric_Pad1.20x1.40mm_HandSolder
R74, R76: 750; R_0805_2012Metric_Pad1.20x1.40mm_HandSolder
R75: 130; R_0805_2012Metric_Pad1.20x1.40mm_HandSolder
R77, R78: 10; R_0805_2012Metric_Pad1.20x1.40mm_HandSolder
R79, R80: 100k; R_0805_2012Metric_Pad1.20x1.40mm_HandSolder
R81: 1k; R_0805_2012Metric_Pad1.20x1.40mm_HandSolder
R82: 2.1k; R_0805_2012Metric_Pad1.20x1.40mm_HandSolder
TP23: 12V; PinHeader_1x01_P2.54mm_Vertical
U16: ISL83485IBZ
U25: ZXTR2012Z-7; ZXTR2012Z7
U29: LM358; SOIC-8_3.9x4.9mm_P1.27mm

Connections:
+3.3V: C93.1, R74.2, U16.8 (VCC)
+5V: J5.20, J6.11, J6.13
GND: C20.2, C48.1, C71.1, C81.2, C82.1, C83.2, C84.1, C86.2, C93.2, C95.2, C96.2, C98.2, J5.0 (PAD), J5.7, J5.19, J5.25, J6.12, J6.14, J6.16, R73.1, R76.1, R79.1, R81.1, U16.5 (GND), U25.1 (GND), U29.4 (V-)
unnamed: C81.1, R72.2, R73.2, U16.2 (*RE), U16.3 (DE)
unnamed: C82.2, R71.2, U16.1 (RO)
unnamed: C83.1, R70.2, U16.4 (DI)
unnamed: C84.2, C85.1, L2.1, R74.1, R75.2, U16.7 (B/Z)
unnamed: C85.2, C86.1, L2.4, R75.1, R76.2, U16.6 (A/Y)
unnamed: C95.1, R80.2, U29.3 (+)
unnamed: C96.1, C98.1, TP23.1, U25.3 (VOUT), U29.8 (V+)
unnamed: L2.2, R77.1
unnamed: L2.3, R78.1
unnamed: R81.2, R82.1, U29.2 (-)
Vs: C20.1, U25.2 (VIN_1), U25.4 (VIN_2)
analog_1: C71.2, J5.24
analog_2: C48.2, J5.18
dir_0: J6.4
dir_1: J6.6
dir_2: J6.8
dir_3: J6.10
drv_enable: J6.2
in_3: J5.3
in_4: J5.4
in_5: J5.5
in_8: J5.8
in_9: J5.9
in_10: J5.10
in_11: J5.11
in_12: J5.12
in_22: J5.22
in_23: J5.23
out_1: J5.1
out_2: J5.2
out_15: J5.15
out_16: J5.16
out_21: J5.21
rs485+: J5.14, R77.2
rs485-: J5.13, R78.2
rs485_ro: R71.1
rs485_rw: R72.1
rs_r85_di: R70.1
spin_0to10: J5.6, J6.15, R82.2, U29.1
spin_pwm: J5.17
spin_pwm_3: R79.2, R80.1
step_0: J6.3
step_1: J6.5
step_2: J6.7
step_3: J6.9
