buildbotics/bbctrl-pcb-new/rpi.kicad_sch

## KiCad design rpi.kicad_sch (2023-07-29)

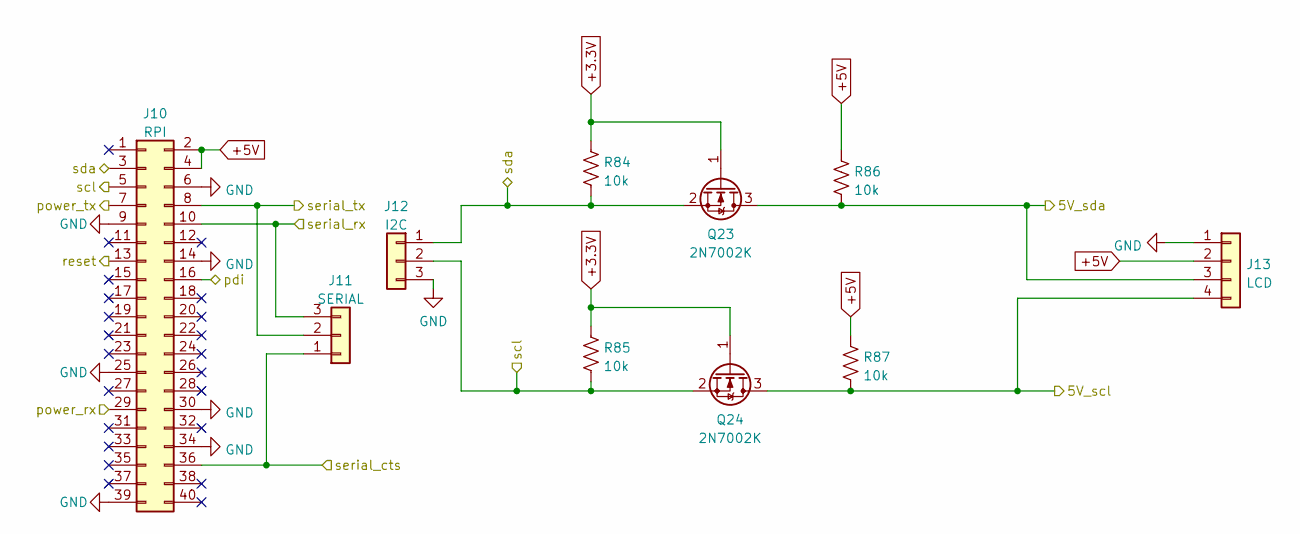
[picture p34: schematic rpi.kicad_sch]

Parts:
J10: RPI; PinHeader_2x20_P2.54mm_Vertical
J11: SERIAL; PinHeader_1x03_P2.54mm_Vertical
J12: I2C; PinHeader_1x03_P2.54mm_Vertical
J13: LCD; PinHeader_1x04_P2.54mm_Vertical
Q23, Q24: 2N7002K; SOT-23
R84, R85, R86, R87: 10k; R_0805_2012Metric_Pad1.20x1.40mm_HandSolder

Connections:
5V_scl: J13.4, Q24.3 (D), R87.2
5V_sda: J13.3, Q23.3 (D), R86.2
+3.3V: Q23.1 (G), Q24.1 (G), R84.1, R85.1
+5V: J10.2, J10.4, J13.2, R86.1, R87.1
GND: J10.6, J10.9, J10.14, J10.25, J10.30, J10.34, J10.39, J12.3, J13.1
pdi: J10.16
power_rx: J10.29
power_tx: J10.7
reset: J10.13
scl: J10.5, J12.2, Q24.2 (S), R85.2
sda: J10.3, J12.1, Q23.2 (S), R84.2
serial_cts: J10.36, J11.1
serial_rx: J10.10, J11.3
serial_tx: J10.8, J11.2
