buildbotics/bbctrl-pcb-new/(commit log)

2022-10-26 first commit of Kicad 6.0 conversion
    [5.0SMDJ48CA.stp, AZ1117IH-3.3TRG1.stp, BuildboticsController.kicad_sch, CDBW.step, DBV0005A.stp, DCP0038A.stp, DDZ6V2BQ-7.stp, DGQ0010D.stp]
2022-10-26 removed autosave file and corrected schematic electrical rules check warnings and errors
    [BuildboticsController.kicad_sch, PowerSupply.kicad_sch, microprocessor.kicad_sch, peripherals.kicad_sch]
2022-10-26 cleared all pcb drc errors and warnings
    [BuildboticsController.kicad_sch, MotorDriver.kicad_sch, PowerSupply.kicad_sch, level_shifter.kicad_sch, microprocessor.kicad_sch, peripherals.kicad_sch, rpi.kicad_sch]
2022-11-12 replaced some parts numbers with parts that are available
    [BuildboticsController-2022-11-12.xlsx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]
2022-11-12 removing fab folder
    [BuildboticsController-2022-11-12.xlsx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]
2022-11-12 removed boms
    [fab_bom_.csv]
2022-11-17 modified file to allow floating 5V buffer oe inputs until boot completes.
    [BuildboticsController.kicad_sch, level_shifter.kicad_sch, microprocessor.kicad_sch]
2023-02-09 updating recent work
    [microprocessor.kicad_sch]
2023-02-12 corrections after first KiCad build
    [BuildboticsController.kicad_sch, MotorDriver.kicad_sch, PowerSupply.kicad_sch, SOT-223_3P7X6P7_ONS.step, SOT23_BC856B_NEX.step, level_shifter.kicad_sch, microprocessor.kicad_sch, peripherals.kicad_sch]
2023-02-12 put all schematics on 50 mil grid
    [BuildboticsController.kicad_sch, MotorDriver.kicad_sch, PowerSupply.kicad_sch, microprocessor.kicad_sch, peripherals.kicad_sch, rpi.kicad_sch]
2023-02-14 minor corrections in prep for new build
    [BuildboticsController.kicad_sch, microprocessor.kicad_sch, peripherals.kicad_sch, rpi.kicad_sch]
2023-02-16 added footprint to U29
    [BuildboticsController.kicad_sch, peripherals.kicad_sch]
2023-04-09 moved DB25 closer to board edge by 0.25 inches
2023-04-26 first commit of V18
    [BuildboticsController.kicad_sch, DDW0044B.stp, DIO_RB731_ROM.step, MotorDriver.kicad_sch, PW0024A.stp, PowerSupply.kicad_sch, microprocessor.kicad_sch, peripherals.kicad_sch]
2023-04-26 added resistor to pull gpio 17 low to show board type
    [BuildboticsController.kicad_sch, rpi.kicad_sch]
2023-04-26 added oled support
    [BuildboticsController.kicad_sch, PowerSupply.kicad_sch, rpi.kicad_sch]
2023-04-27 added pull-up to buffer_enable
    [BuildboticsController.kicad_sch, microprocessor.kicad_sch]
2023-04-27 made space for 1/2" bu 4" heat sink bar on pcb
2023-04-28 motor driver improvements including corrected cap P/N, connected 3.3V to Vcc, and added exposed copper plane on back
    [BuildboticsController.kicad_sch, MotorDriver.kicad_sch]
2023-05-01 added some testpoints
    [BuildboticsController.kicad_sch, PowerSupply.kicad_sch, microprocessor.kicad_sch, peripherals.kicad_sch]
2023-05-05 corrected solder mask for Molex connectors
    [BuildboticsController.kicad_sch, PowerSupply.kicad_sch]
2023-07-07 updated some part numbers
    [MotorDriver.kicad_sch, PowerSupply.kicad_sch, peripherals.kicad_sch]
2023-07-27 Fixed absolute paths, Renamed footprints and models folders
    [5.0SMDJ48CA.stp, AZ1117IH-3.3TRG1.stp, CDBW.step, DBV0005A.stp, DCP0038A.stp, DDW0044B.stp, DDZ6V2BQ-7.stp, DGQ0010D.stp]
2023-07-27 Move back to drv8711
    [BuildboticsController.kicad_sch, MotorDriver.kicad_sch, PowerSupply.kicad_sch, level_shifter.kicad_sch, microprocessor.kicad_sch, peripherals.kicad_sch, rpi.kicad_sch]
2023-07-29 All DRC errors cleared after conversion to Kicad V7
    [MotorDriver.kicad_sch, PowerSupply.kicad_sch, level_shifter.kicad_sch, microprocessor.kicad_sch, peripherals.kicad_sch, rpi.kicad_sch]
2023-07-31 changed level shifter symbol
    [MotorDriver.kicad_sch, PowerSupply.kicad_sch, level_shifter.kicad_sch, peripherals.kicad_sch]
2023-08-10 made all electrolytic caps have thermal relief and made high current zones have solid relief
    [PowerSupply.kicad_sch]
2023-08-10 added decoupling cap to U16, fixed DRC param, and corrected resulting clearance violations
    [peripherals.kicad_sch]
2023-08-14 fixed footprint for q5 and q6, improved DRV8711 layout, oriented all 22uf caps the same direction
    [PowerSupply.kicad_sch]
2023-09-02 adjusted footprint and position motor port connectors
    [MotorDriver.kicad_sch]
2023-09-07 changed 12V supply for 0-10V out to LDO voltage regulator
    [PowerSupply.kicad_sch, peripherals.kicad_sch]
2023-09-07 swapped avr pins 21 and 23 (mosi and sck) to accomodate xmegaa3 chip
    [microprocessor.kicad_sch]
2023-09-07 make power_tx level shifter hard enabled
    [PowerSupply.kicad_sch, level_shifter.kicad_sch]
2023-09-09 changed mosi and sck resistors from 180 ohm to 100 ohm
    [microprocessor.kicad_sch]
2023-09-12 final changes for fab, added silkscreen labels, improved routing on 0-10 ckt
2024-01-30 Replaced D6 with previous part and corrected R13 footprint
    [PowerSupply.kicad_sch, level_shifter.kicad_sch]
2024-01-30 updated board version to 18
