buildbotics/bbctrl-pcb-new/(notices)

Notices in the files:
level_shifter.kicad_sch:
Copyright (c) 2016-2022, Buildbotics LLC
Licensed under CERN-OHL-S v2
microprocessor.kicad_sch:
Copyright (c) 2016-2023, Buildbotics LLC
